richard-burak/richard-burak.github.io/Documents/Solar Project Status Report 5, Richard Burak.docx

CENG 317 - Solar Project Status Report

To Kristian Medri,

This status report will give information regarding the progress made on the Solar Panel project. Since the last status report, an additional circuit board for the project has been printed and is ready to be soldered. I ordered and received six 5-pin female headers for the PCB, similar to the ones used in the Modular Sensor Hat.

These headers cost about $13 after tax and shipping, but the members of the solar project group are splitting cost, so it ends up being a little over $4, which still leaves me under budget.

Only one PCB has been printed by Steven, this is in order to test the design and make sure it works before printing more. While Steven is soldering on Nov 22nd, I will be responsible for creating the design for the laser cut case. This is possible now because we can have the exact measurements of the hardware.

Finally, the Python code on the Pi has been updated to show when an issue is occurring with any sensor. The LED will be red when a sensor is not detected or malfunctioning, while it will remain green if everything is working as expected.

I hope this status report provides sufficient evidence of my progress and work. Week 12 has no other deliverables due, and I am close to finalizing my project for this semester.

Sincerely,

Richard Burak

Richard Burak November 22nd, 2016
