richard-burak/richard-burak.github.io/Documents/Solar Project Status Report 4, Richard Burak.docx

CENG 317 - Solar Project Status Report

To Kristian Medri,

This status report will give information regarding the progress made on the Solar Panel project. Since the last status report, an additional circuit board for the project has been designed, and is ready to print. I must email the files to the Prototype Lab, and will receive and test it once it has been printed.

The purpose of this PCB is to make the the design simpler, more solid, and better looking. It will plug into the GPIO pins on the top of the Modular Sensor Hat. The only additional prototyping wire required is to connect the solar cell to the ADC.

I must still design a case for the project, and hope to do so once it works with the custom PCB. I must be sure of the project’s dimensions before proceeding with this step. Finally, a database is already in place and working. I just have to create the code to insert the data from the Pi.

I hope this status report provides sufficient evidence of my progress and work. Week 11 has no other deliverables due, and the only progress made is on the custom PCB.

Sincerely,

Richard Burak

Richard Burak November 15th, 2016
