richard-burak/richard-burak.github.io/Images/corel_box.png

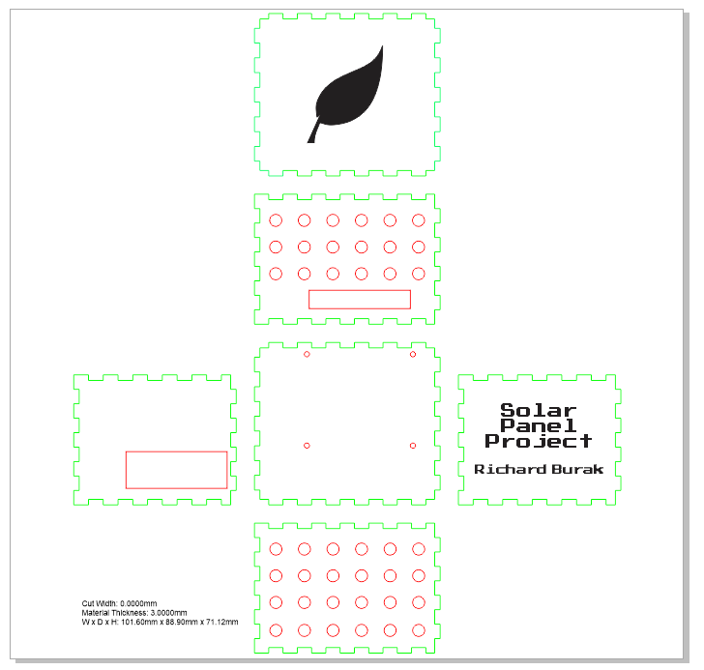
Images/corel_box.png
