richard-burak/richard-burak.github.io/Images/custom_board.png

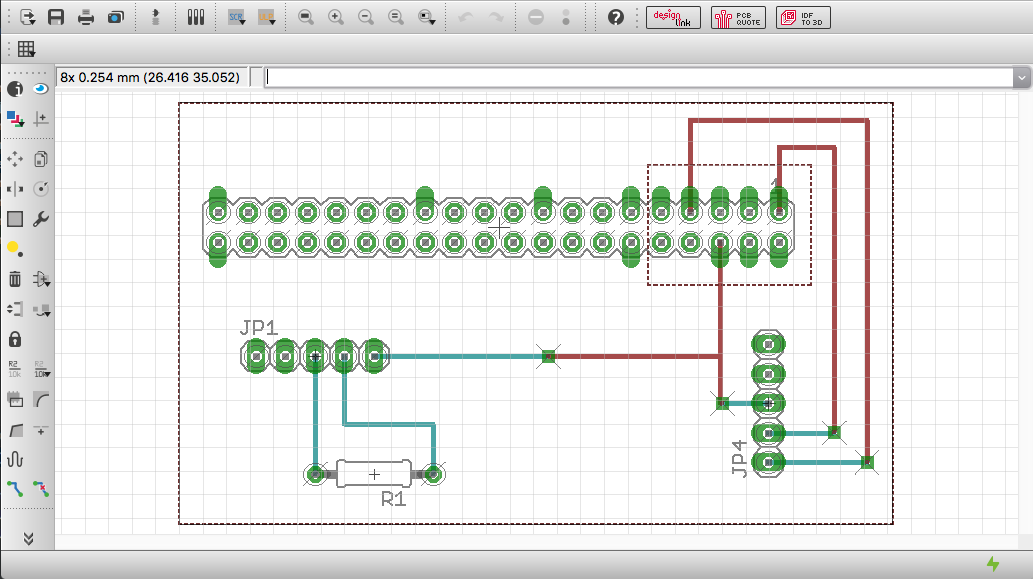
Images/custom_board.png
