richard-burak/richard-burak.github.io/Images/custom_pcb_done.jpeg

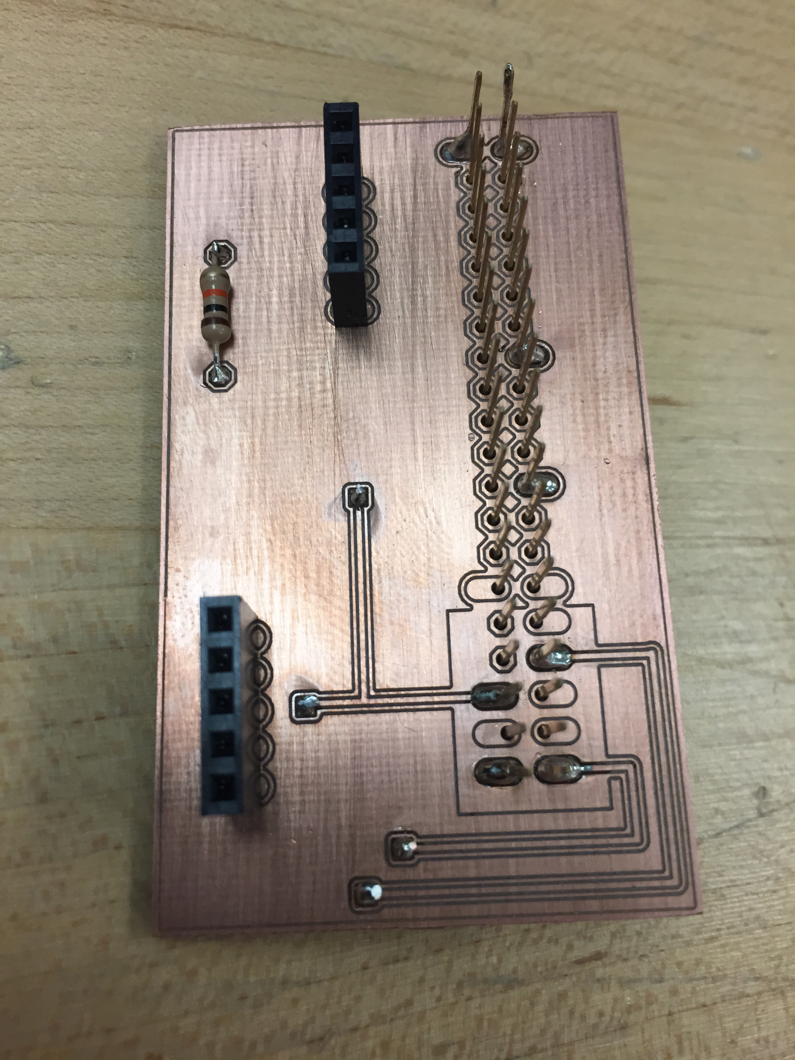
Images/custom_pcb_done.jpeg
