richard-burak/richard-burak.github.io/Images/final_box.jpeg

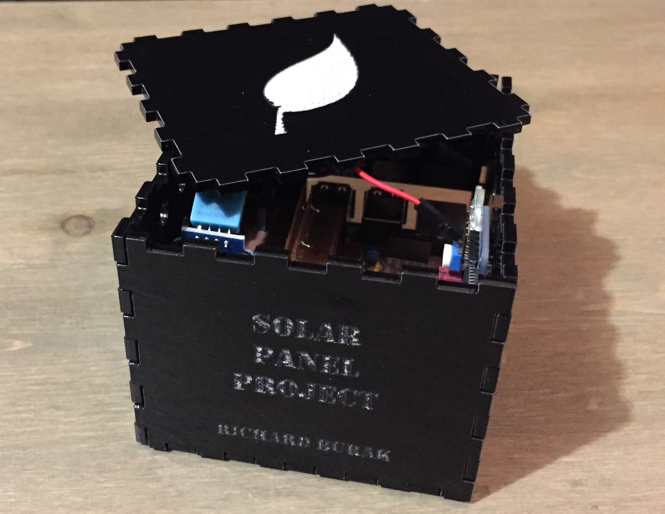
Images/final_box.jpeg
