richard-burak/richard-burak.github.io/Images/headers.jpeg

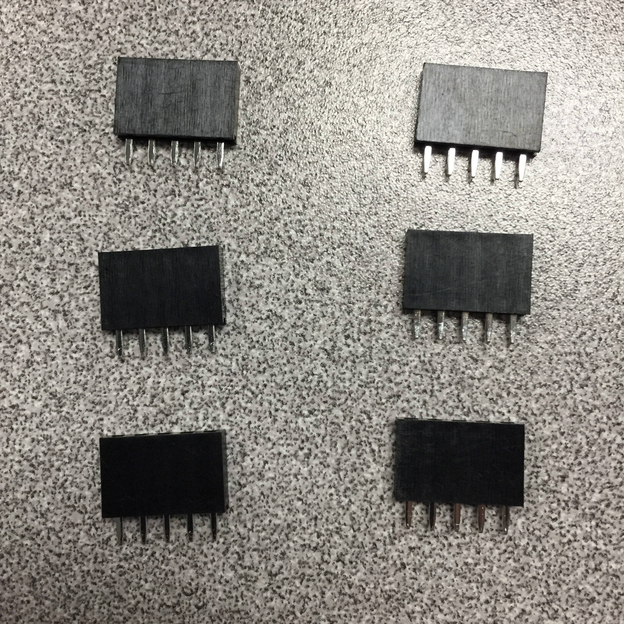
Images/headers.jpeg
