richard-burak/richard-burak.github.io/Images/Layout.png

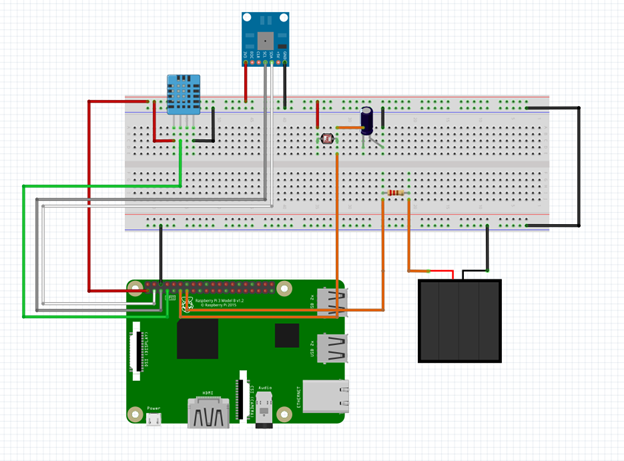
Images/Layout.png
