richard-burak/richard-burak.github.io/Images/LEDgreen.jpeg

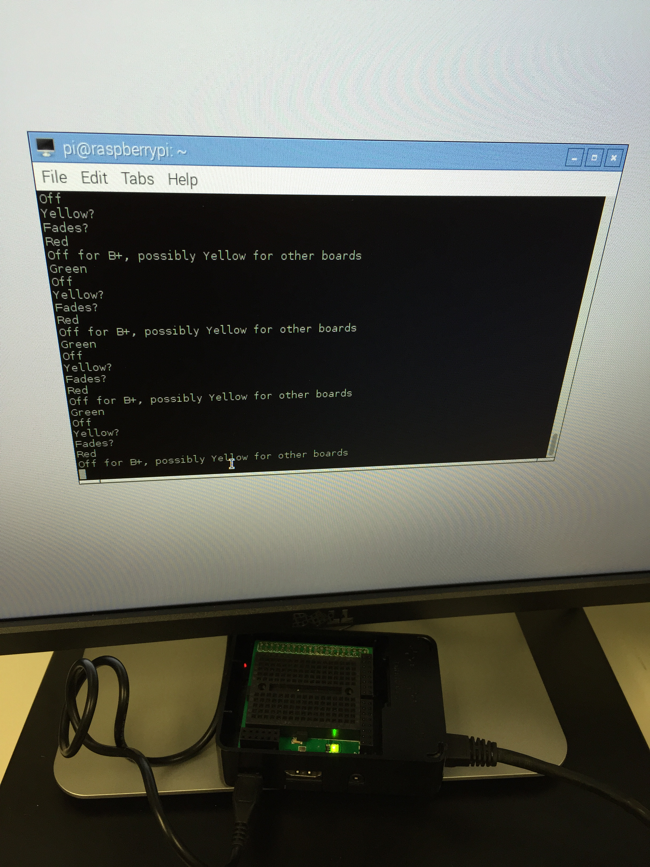
Images/LEDgreen.jpeg
