richard-burak/richard-burak.github.io/Images/LEDoff copy.jpeg

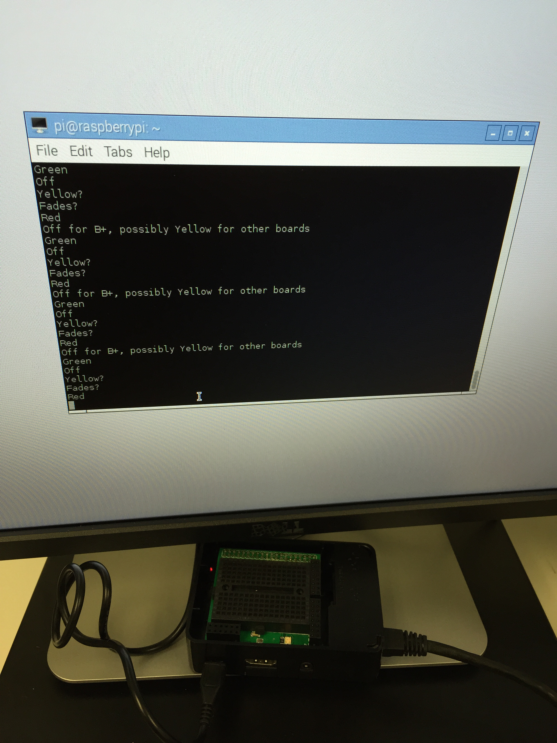
Images/LEDoff copy.jpeg
