richard-burak/richard-burak.github.io/Images/LightSensor.png

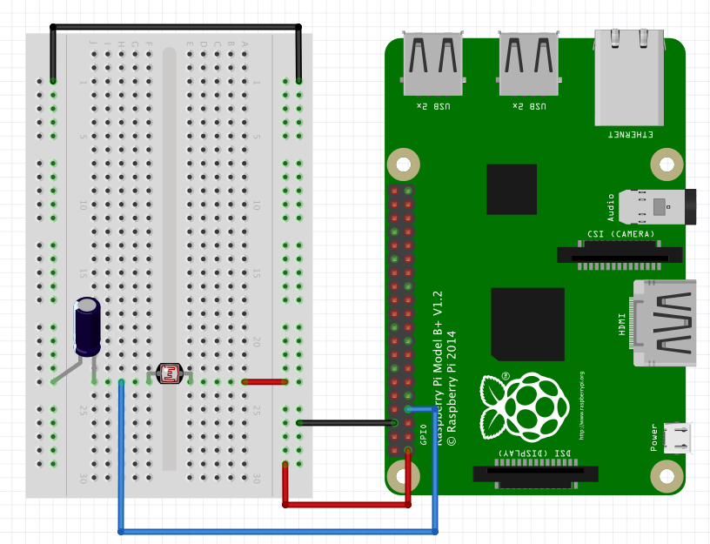
Images/LightSensor.png
