richard-burak/richard-burak.github.io/Images/pcb01.JPG

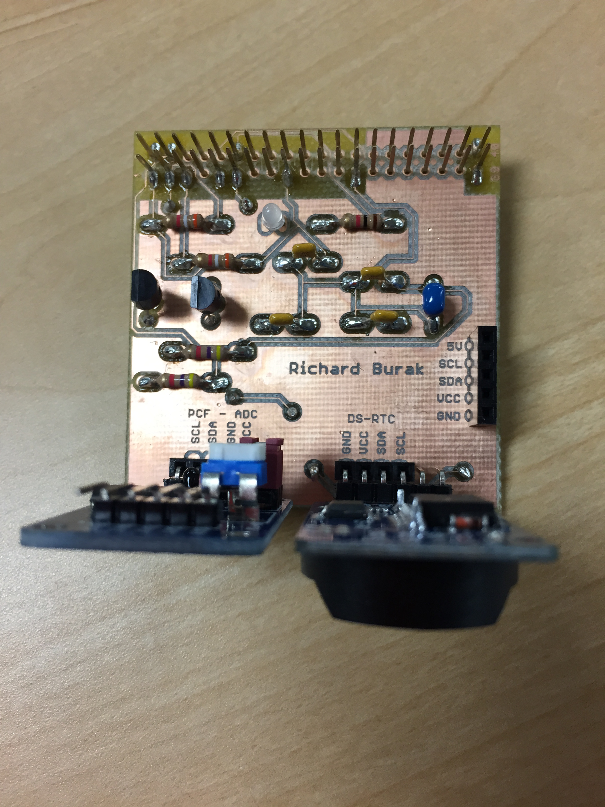
Images/pcb01.JPG
