richard-burak/richard-burak.github.io/Images/pcb02.JPG

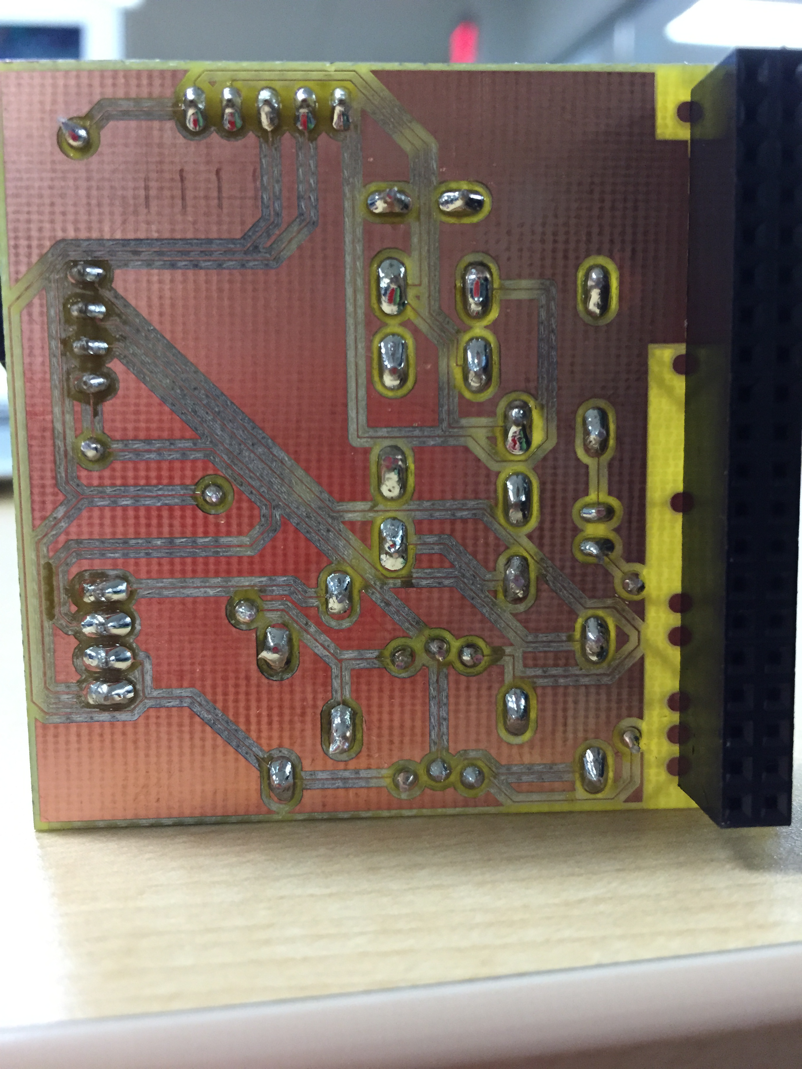
Images/pcb02.JPG
