richard-burak/richard-burak.github.io/Images/solar_placard.png

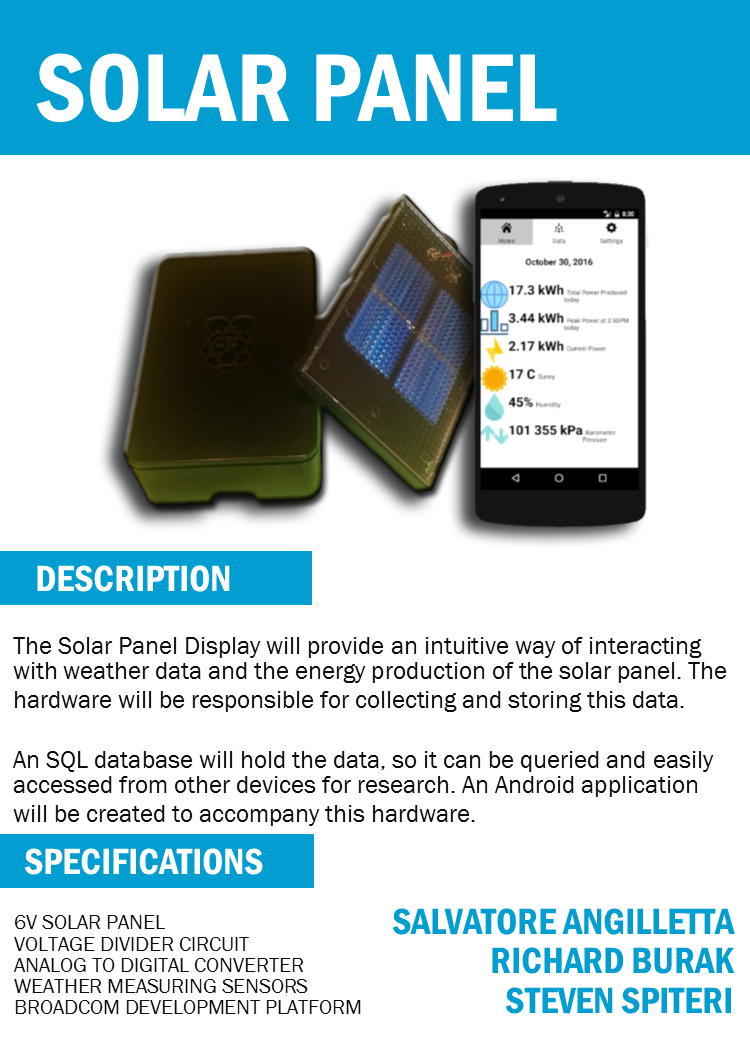
Images/solar_placard.png
