richard-burak/richard-burak.github.io/Documents/Solar Project Budget (Updated), Richard Burak.xlsx

CENG 317 - Solar Project Budget | Author: Richard Burak |  | Date: November 27th
Item | Quantity | Retailer/Source | Item Cost | Tax | Shipping Cost | Total Item Cost | Web Link
CanaKit Raspberry Pi 3 Ultimate Starter Kit | 1 | Amazon.ca/CanaKit | $119.99 | $15.60 | $0.00 | $135.59 | Link (https://www.amazon.ca/CanaKit-Raspberry-Ultimate-Starter-Kit/dp/B01CCF9BYG)
Barometric Pressure Sensor | 1 | RobotShop | $8.33 | $1.08 | $6.27 | $15.68 | Link (http://www.robotshop.com/ca/en/octopus-barometric-pressure-sensor-brick.html)
Humidity/Temperature Sensor - DHT11 | 1 | RobotShop | $4.04 | $0.53 | $6.27 | $10.84 | Link (http://www.robotshop.com/ca/en/electronic-brick-humidity-temperature-sensor.html)
Humber PCB Components Kit | 1 | Humber College | $40.00 | $0.00 | $0.00 | $40.00 | N/A
#22 Gauge Red Wire (25') | 1 | RobotShop | $2.88 | $0.37 | $6.27 | $9.52 | Link (http://www.robotshop.com/ca/en/elenco-22-gauge-red-25-ft.html)
Lead Free Solder (10g) | 1 | RobotShop | $4.49 | $0.58 | $6.27 | $11.34 | Link (http://www.robotshop.com/ca/en/lead-free-solder-wire-10g-tube.html)
Soldering Iron (25W) | 1 | RobotShop | $6.80 | $0.88 | $6.27 | $13.95 | Link (http://www.robotshop.com/ca/en/elenco-sr-1-standard-25w-pencil-soldering-iron.html)
Soldering Iron Holder | 1 | RobotShop | $4.56 | $0.59 | $6.27 | $11.42 | Link (http://www.robotshop.com/ca/en/elenco-soldering-iron-holder.html)
5-pin PCB Header (female) | 2 | Digikey | $0.89 | $0.12 | $8.00 | $9.01 | Link (http://www.digikey.ca/product-detail/en/sullins-connector-solutions/PPTC051LFBN-RC/S6103-ND/807239)
 |  |  |  | GRAND TOTAL: |  | $248.35
 |  |  |  | GRAND TOTAL (Bulk)*: |  | $219.74
 |  |  |  |  |  | *RobotShop bulk order will reduce shipping cost
