richard-burak/richard-burak.github.io/Documents/Solar Project Budget, Richard Burak.xlsx

CENG 317 - Solar Project Budget | Author: Richard Burak
Item | Quantity | Retailer/Source | Item Cost | Tax | Shipping Cost | Total Item Cost | Web Link
CanaKit Raspberry Pi 3 Ultimate Starter Kit | 1 | Amazon.ca/CanaKit | $119.99 | $15.60 | $0.00 | $135.59 | Link (https://www.amazon.ca/CanaKit-Raspberry-Ultimate-Starter-Kit/dp/B01CCF9BYG)
Photoresistor - GL5528 LDR | 4 | Amazon.ca/SODIAL® | $7.72 | $1.00 | $0.00 | $8.72 | Link (https://www.amazon.ca/SODIAL-Photoresistor-GL5528-Resistors-Light-Dependent/dp/B0157PFTS0)
Temperature Sensor - TMP36 | 2 | RobotShop | $3.84 | $0.50 | $6.27 | $10.61 | Link (http://www.robotshop.com/ca/en/temperature-sensor-tmp36.html)
Mini PIR Motion Sensor | 1 | RobotShop | $7.56 | $0.98 | $6.27 | $14.81 | Link (http://www.robotshop.com/ca/en/mini-pir-motion-sensor.html)
Barometric Pressure Sensor | 1 | RobotShop | $8.33 | $1.08 | $6.27 | $15.68 | Link (http://www.robotshop.com/ca/en/octopus-barometric-pressure-sensor-brick.html)
Humidity/Temperature Sensor - DHT11 | 1 | RobotShop | $4.04 | $0.53 | $6.27 | $10.84 | Link (http://www.robotshop.com/ca/en/electronic-brick-humidity-temperature-sensor.html)
Humber PCB Components Kit | 1 | Humber College | $40.00 | $0.00 | $0.00 | $40.00 | N/A
#22 Gauge Red Wire (25') | 1 | RobotShop | $2.88 | $0.37 | $6.27 | $9.52 | Link (http://www.robotshop.com/ca/en/elenco-22-gauge-red-25-ft.html)
#22 Gauge Black Wire (25') | 1 | RobotShop | $2.88 | $0.37 | $6.27 | $9.52 | Link (http://www.robotshop.com/ca/en/elenco-22-gauge-black-25-ft.html)
Resistor Pack (Various Values) | 1 | RobotShop | $10.19 | $1.32 | $6.27 | $17.78 | Link (http://www.robotshop.com/ca/en/1-4w-resistor-kit-500pk.html)
Solderless Breadboard | 1 | RobotShop | $4.76 | $0.62 | $6.27 | $11.65 | Link (http://www.robotshop.com/ca/en/400-tie-point-solderless-interlocking-breadboard.html)
Lead Free Solder (10g) | 2 | RobotShop | $8.98 | $1.17 | $6.27 | $16.42 | Link (http://www.robotshop.com/ca/en/lead-free-solder-wire-10g-tube.html)
Soldering Iron (25W) | 1 | RobotShop | $6.80 | $0.88 | $6.27 | $13.95 | Link (http://www.robotshop.com/ca/en/elenco-sr-1-standard-25w-pencil-soldering-iron.html)
Soldering Iron Holder | 1 | RobotShop | $4.56 | $0.59 | $6.27 | $11.42 | Link (http://www.robotshop.com/ca/en/elenco-soldering-iron-holder.html)
Wire Cutter | 1 | Amazon.ca/Xcelite | $8.39 | $1.09 | $0.00 | $9.48 | Link (https://www.amazon.ca/Xcelite-170M-General-Shearcutter-Diagonal/dp/B0002BBZIS)
Wire Stripper | 1 | Amazon.ca/Jonard Ind. | $12.91 | $1.68 | $0.00 | $14.59 | Link (https://www.amazon.ca/Jonard-Industries-Wire-Stripper-20-30/dp/B006962E7G)
Heat Shrink (10pk) | 1 | RobotShop | $6.35 | $0.83 | $6.27 | $13.45 | Link (http://www.robotshop.com/ca/en/6-multi-colored-heat-shrink-10pk.html)
Digital Multimeter | 1 | RobotShop | $14.67 | $1.91 | $6.27 | $22.85 | Link (http://www.robotshop.com/ca/en/m-1000e-compact-digital-multimeter.html)
Plastic PCB Standoff (50pc) | 1 | Amazon.ca/uxcell | $5.36 | $0.70 | $0.00 | $6.06 | Link (https://www.amazon.ca/Female-Thread-Pillar-Standoff-Hexagonal/dp/B00VG93RZ4)
 |  |  |  | GRAND TOTAL: |  | $392.95
 |  |  |  | GRAND TOTAL (Bulk)*: |  | $305.38
 |  |  |  |  |  | *RobotShop bulk order will reduce shipping cost
