richard-burak/richard-burak.github.io/BuildFiles/HSHV4-student version.brd

## EAGLE design BuildFiles/HSHV4-student version.brd (2016-12-03)

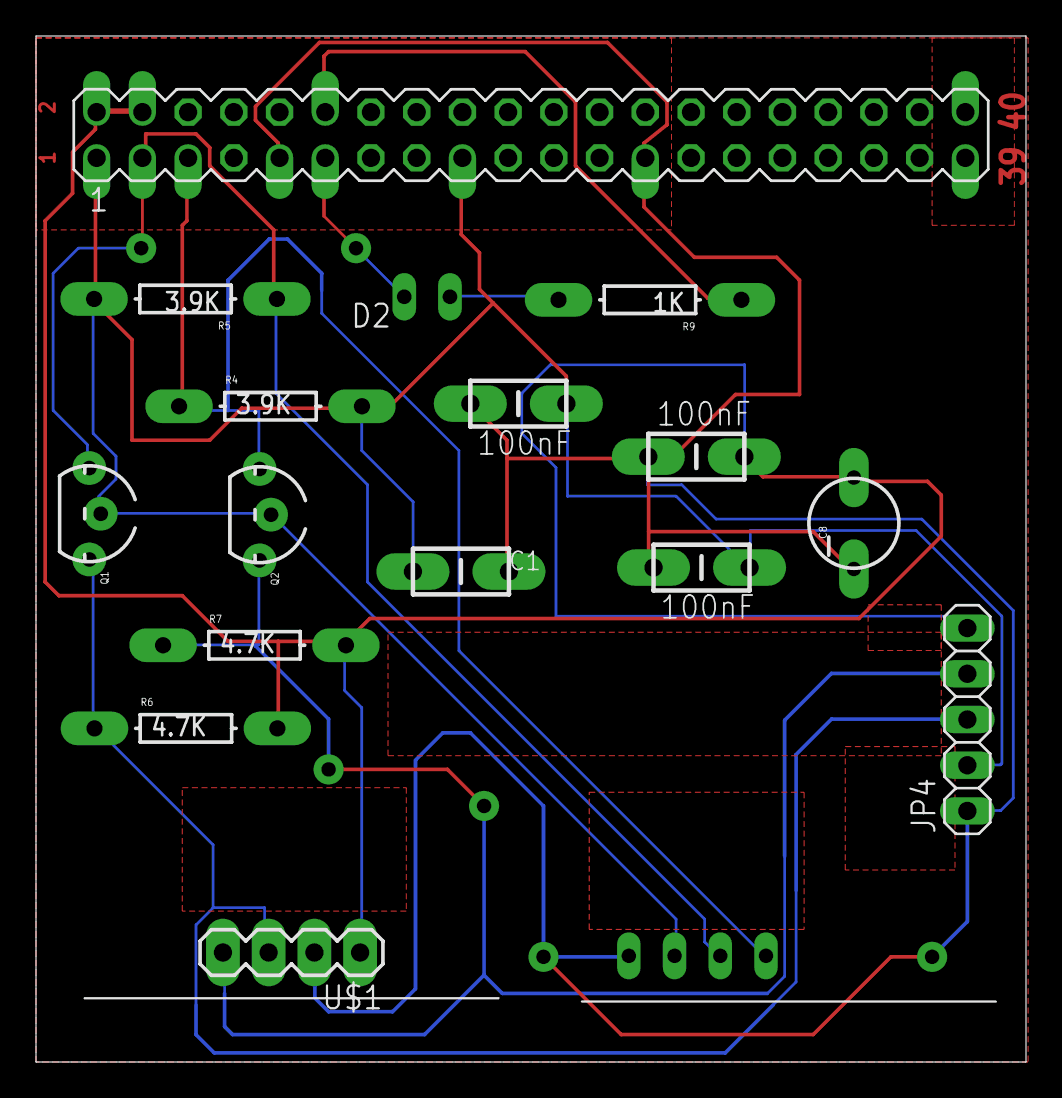
[picture p20: board HSHV4-student version.brd from above]

Board: 2 copper layers, 55.0 x 57.0 mm, 17 parts (0 on the bottom side), 10 nets.

Parts:
C1, C2, C4, C5: 100nF; CAP-PTH-SMALL-KIT
C8: 10uF; CPOL-RADIAL-10UF-25V
D2: LED3MM-NS
IC1: DS3231; 8PTH
JP4: 1X05
K1: PIN20X2; PIN_20X2
Q1, Q2: MOSFET-NCHANNEL2N7000; TO-92
R4, R5: 3.9K; AXIAL-0.3
R6, R7: 4.7K; AXIAL-0.3
R9: 1K; AXIAL-0.3
U$1: PCF8591; 1X04

Connections:
+3V3: C1.1, C2.1, C4.2, IC1.2, JP4.2, K1.1, K1.17, Q1.2, Q2.2, R4.P$2, R5.P$2
+5V: C5.2, C8.1, JP4.5, K1.2, K1.4, R6.P$2, R7.P$2, U$1.1
GND: C1.2, C2.2, C4.1, C5.1, C8.2, IC1.1, JP4.1, K1.9, K1.25, U$1.2
GPIO17: D2.K, K1.11
GPIO18: K1.12, R9.P$1
unnamed: D2.A, R9.P$2
SCL1-3: IC1.4, K1.5, Q2.1, R4.P$1
SCL1-5: JP4.4, Q2.3, R7.P$1, U$1.4
SDA1-3: IC1.3, K1.3, Q1.1, R5.P$1
SDA1-5: JP4.3, Q1.3, R6.P$1, U$1.3
