richard-burak/richard-burak.github.io/BuildFiles/solarpanel2.brd

## EAGLE design BuildFiles/solarpanel2.brd (2016-12-03)

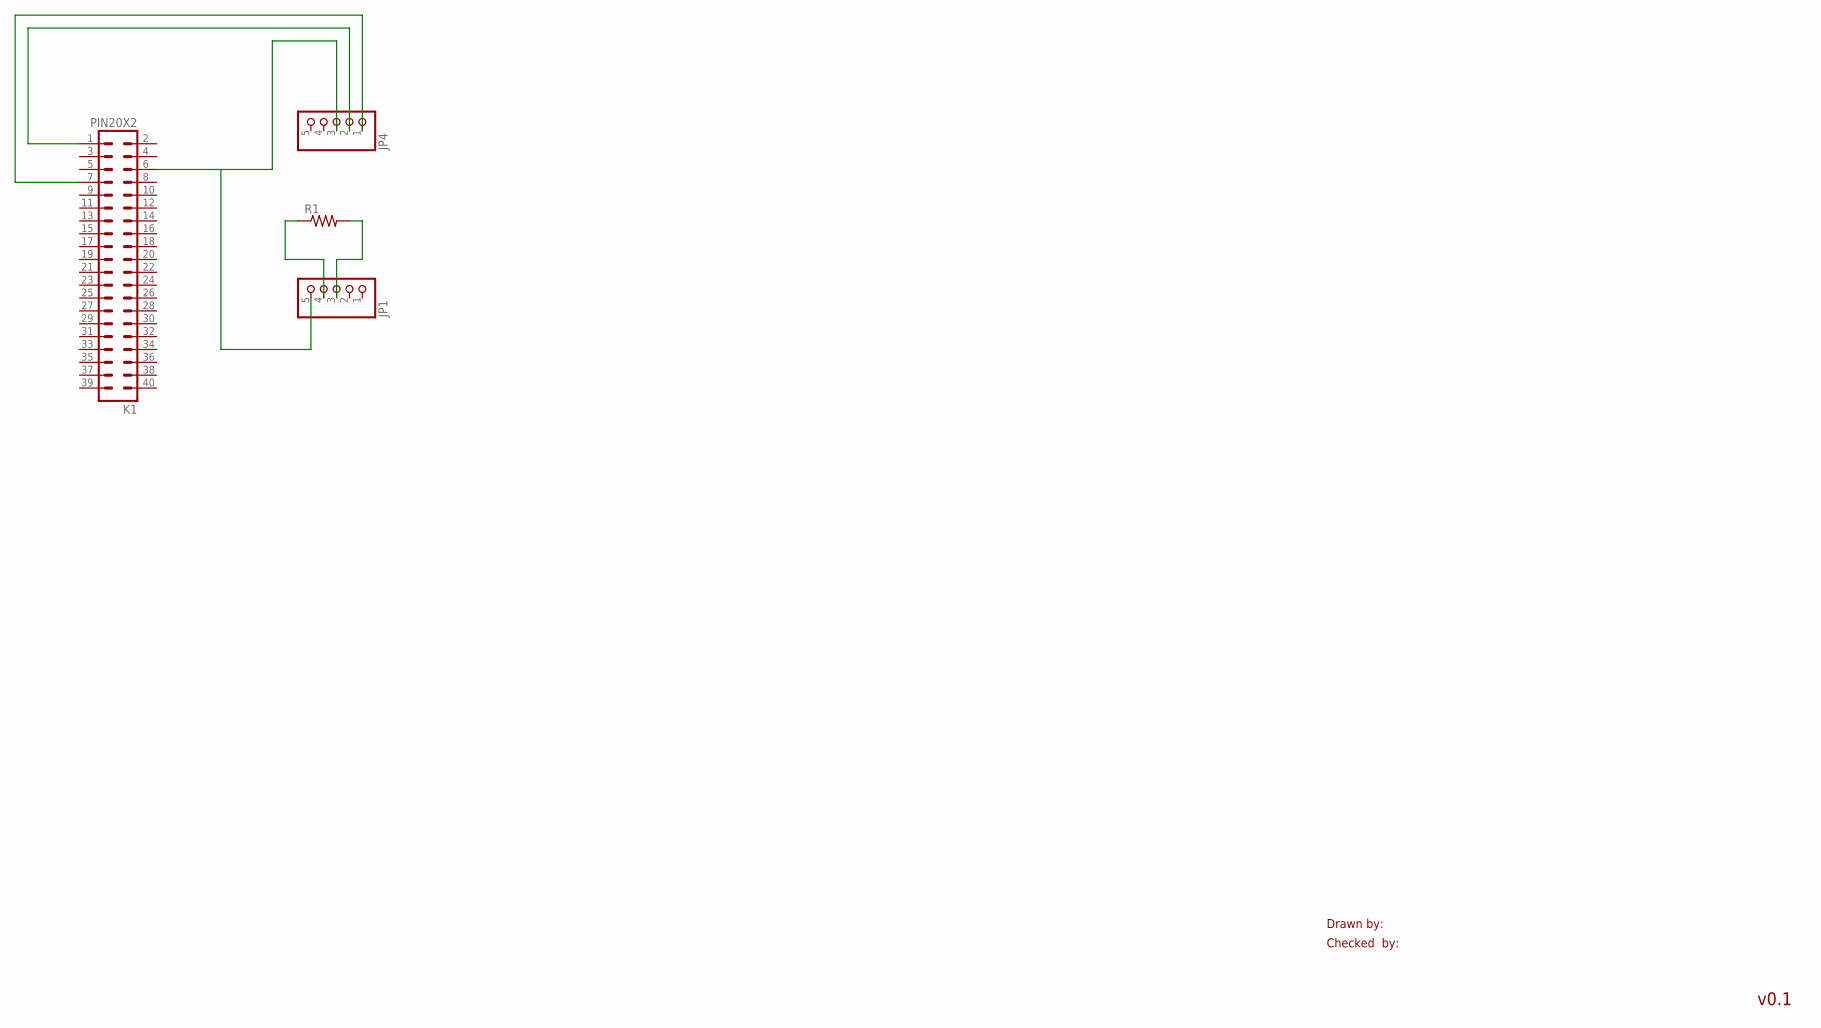
[picture p21: schematic solarpanel2.sch]

Parts:
JP1, JP4: PINHD-1X5; 1X05
K1: PIN20X2; PIN_20X2
R1: R-US_0207/10; 0207/10

Connections:
unnamed: JP4.1, K1.7
unnamed: JP4.2, K1.1
unnamed: JP1.5, JP4.3, K1.6
unnamed: JP1.4, R1.1
unnamed: JP1.3, R1.2

Notes on the sheet:
Drawn by:
Checked by:
v0.1

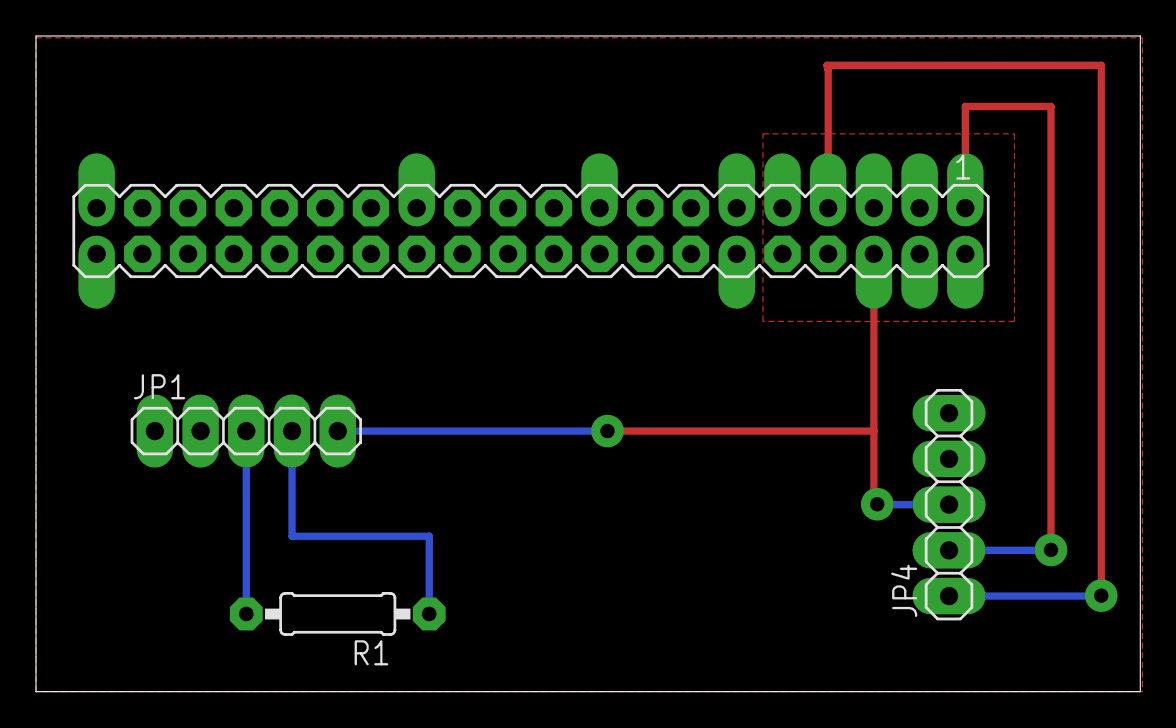
[picture p22: board solarpanel2.brd from above]

Board: 2 copper layers, 61.4 x 36.4 mm, 4 parts (0 on the bottom side), 5 nets.
