richard-burak/richard-burak.github.io/(commit log)

2016-09-25 Webpage Updated
    -Updated page to include project related materials
    -Added personal customization
    [Solar Project Budget, Richard Burak.xlsx]
2016-10-11 Webpage Updated
    -Week 6 materials added
    -Video added
2016-10-13 Webpage Updated
    -Added PCB images
    -Updated Report #2
2016-11-15 Updated Website
    Added Week 11 materials, created build log entry.
2016-11-28 Updated Webpage and Folder Structure
    -Changed to new folder structure
    -Added Week 13 content
    [Solar Project Budget, Richard Burak.xlsx]
2016-11-29 Updated Webpage
    -Added updated budget
    [Solar Project Budget (Updated), Richard Burak.xlsx]
2016-12-03 Webpage Updated
    -Moved build instructions to separate page.
    [HSHV4-student version.brd, HSHV4-student version.sch, solarpanel2.brd, solarpanel2.sch]
